tombueng/LumiGate/hardware/3d/XLR-328P.step

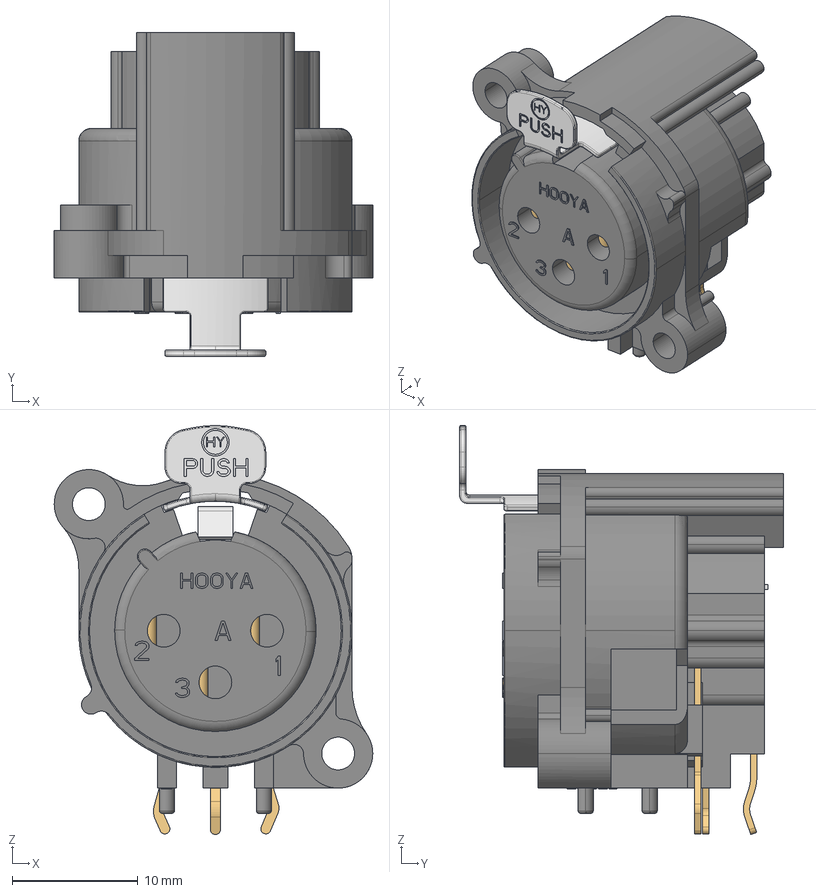
[picture p10: CAD file, 2026-06-14]
hardware/3d/XLR-328P.step
25.3 x 25.7 x 32.5 mm
