tombueng/LumiGate/hardware/lumigate.kicad_pcb

## KiCad design hardware/lumigate.kicad_pcb (2026-06-14)

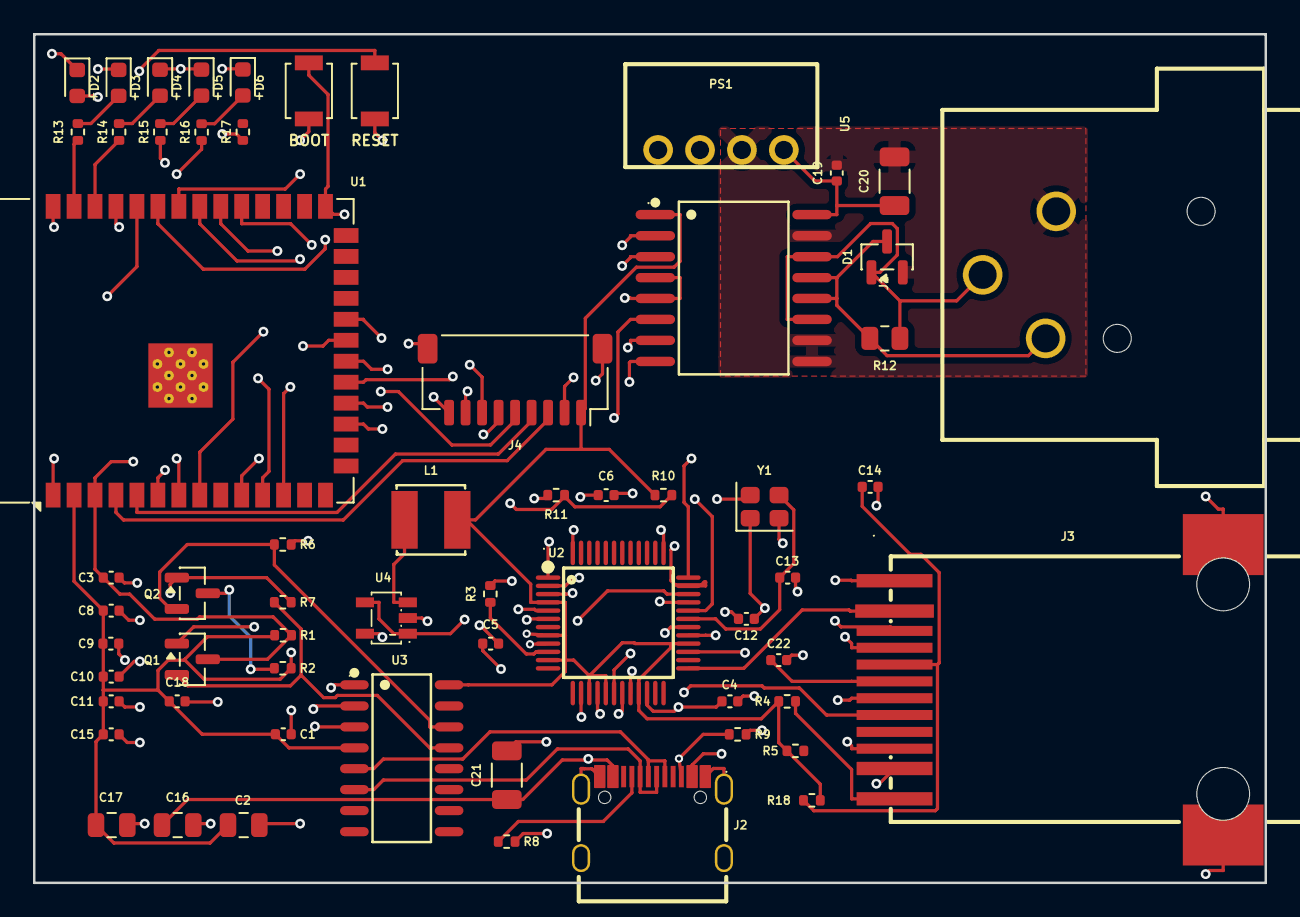
[picture p11: board lumigate.kicad_pcb from above]

Board: 4 copper layers, 74.6 x 51.4 mm, 61 parts (0 on the bottom side), 61 nets.

Parts:
C1, C5, C8, C9, C10, C11, C14, C15, C18, C19, C22: 100nF; C_0402_1005Metric
C2: 10uF; C_0805_2012Metric
C3, C4: 1uF; C_0402_1005Metric
C6: 4.7uF; C_0402_1005Metric
C12, C13: 22pF; C_0402_1005Metric
C16, C17: 22uF; C_0805_2012Metric
C20, C21: 10uF; C_1206_3216Metric
D1: SM712; SOT-23
D2, D3, D4, D5, D6: LED; LED_0603_1608Metric
J1: XLR-3 out; CONN-TH_XLR-328P
J2: USB-C; USB-C_SMD-TYPE-C-31-M-12_1
J3: J3; RJ45-SMD_HR961160C
J4: DISP SH9; JST_SH_SM09B-SRSS-TB_1x09-1MP_P1.00mm_Horizontal
L1: L1; IND-SMD_L4.0-W4.0
PS1: B0505S-1W; PWRM-TH_B0505S-1W
Q1, Q2: MMBT3904; SOT-23
R1, R2, R6, R7, R11: 10k; R_0402_1005Metric
R3: 12k; R_0402_1005Metric
R4, R5: 330R; R_0402_1005Metric
R8, R9: 5k1; R_0402_1005Metric
R10: 45.3k; R_0402_1005Metric
R12: 120R; R_0805_2012Metric
R13, R15: 1k; R_0402_1005Metric
R14, R16, R17: 180R; R_0402_1005Metric
R18: 49.9R; R_0402_1005Metric
SW1: BOOT; SW_SPST_B3U-1000P
SW2: RST; SW_SPST_B3U-1000P
U1: ESP32-S3-WROOM-1-N8; ESP32-S3-WROOM-1
U2: W5500; LQFP-48_L7.0-W7.0-P0.50-LS9.0-BL
U3: U3; SOP-16_L10.0-W3.9-P1.27-LS6.0-BL
U4: SY8089; SOT-23-5_L3.0-W1.7-P0.95-LS2.8-BR
U5: U5; SOIC-16_L10.3-W7.5-P1.27-LS10.3-BL
Y1: 25MHz; Crystal_SMD_2520-4Pin_2.5x2.0mm

Connections:
+3V3: C1.1, C2.1, C8.1, C9.1, C10.1, C11.1, C15.1, C17.1, C18.1, J4.1, L1.2, R1.1, R2.1, R4.1, R5.1, R10.1, R18.2, U1.2, U2.4, U2.8, U2.11, U2.15, U2.17, U2.21, U2.28, U3.4, U3.16, U5.1
+5V: C16.1, C21.1, J2.A4B9, J2.B4A9, PS1.2, U4.1, U4.4
BUCK_FB: R10.2, R11.1, U4.5
BUCK_LX: L1.1, U4.3
CC1: J2.A5, R8.1
CC2: J2.B5, R9.1
DISP_CS: J4.7, U1.34
DISP_DC: J4.8, U1.35
DISP_MOSI: J4.6, U1.33
DISP_RST: J4.9, U1.31
DISP_SCK: J4.5, U1.32
DISP_SCL: J4.4, U1.5
DISP_SDA: J4.3, U1.4
DMX_A: D1.1, J1.3, R12.1, U5.11, U5.14
DMX_B: D1.3, J1.2, R12.2, U5.12, U5.13
DMX_EN: U1.12, U5.4, U5.5
DMX_RX: U1.11, U5.3
DMX_TX: U1.10, U5.6
DTR: Q1.2, R7.1, U3.13
EN: C3.1, Q1.3, R1.2, SW2.1, U1.3
ETH_ACTLED: J3.11, U2.27
ETH_CS: U1.18, U2.32
ETH_INT: U1.22, U2.36
ETH_LINKLED: J3.2, U2.25
ETH_RCT: C22.1, J3.6
ETH_RST: U1.17, U2.37
ETH_RXN: J3.8, U2.5
ETH_RXP: J3.7, U2.6
ETH_TCT: C14.1, J3.5, R18.1
ETH_TXN: J3.4, U2.1
ETH_TXP: J3.3, U2.2
GND: C1.2, C2.2, C3.2, C4.2, C5.2, C6.2, C8.2, C9.2, C10.2, C11.2, C12.2, C13.2, C14.2, C15.2, C16.2, C17.2, C18.2, C21.2, C22.2, D2.1, D3.1, D4.1, D5.1, D6.1, J2.1, J2.2, J2.3, J2.4, J2.A1B12, J2.B1A12, J3.10, J3.13, J3.14, J4.2, J4.MP, PS1.1, R3.2, R8.2, R9.2, R11.2, SW1.2, SW2.2, U1.1, U1.40, U1.41, U2.3, U2.9, U2.14, U2.16, U2.19, U2.29, U2.48, U3.1, U4.2, U5.2, U5.7, U5.8, Y1.2, Y1.4
GNDISO: C19.2, C20.2, D1.2, J1.1, PS1.3, U5.9, U5.10, U5.15
IO0: Q2.3, R2.2, SW1.1, U1.27
LED_B: R16.1, U1.7
LED_G: R14.1, U1.38
LED_R: R13.1, U1.39
LED_W: R17.1, U1.8
LED_Y: R15.1, U1.6
MISO: U1.21, U2.34
MOSI: U1.19, U2.35
unnamed: R3.1, U2.10
unnamed: J3.1, U2.18
unnamed: J3.12, R4.2
unnamed: Q1.1, R6.2
unnamed: D2.2, Q2.1, R7.2
unnamed: D3.2, R13.2
unnamed: D4.2, R14.2
unnamed: D5.2, R15.2
unnamed: D6.2, R16.2
RTS: Q2.2, R6.1, U3.14
S3_RX: U1.36, U3.2
S3_TX: U1.37, U3.3
SCLK: U1.20, U2.33
TOCAP: C6.1, U2.20
USB_DM: J2.A7, J2.B7, U3.6
USB_DP: J2.A6, J2.B6, U3.5
VISO: C19.1, C20.1, PS1.4, U5.16
W5500_1V2: C4.1, C5.1, U2.22
XI: C12.1, U2.30, Y1.1
XO: C13.1, U2.31, Y1.3
