tombueng/LumiGate/(commit log)

2026-05-21 Initial release: LumiGate v1.0
    Art-Net → DMX512 gateway firmware for ESP32 with live WebSocket UI,
    manual DMX control, OTA updates, mDNS, and NVS config persistence.
2026-05-21 Add footer attribution, resize logo for README, wiring diagram SVG
    - Footer with copyright, GitHub link, MIT license on all three web pages
    - docs/logo.png: 300x300 version for README
    - docs/wiring.svg: rendered wiring diagram
2026-05-21 Add logo to web UI nav bar and README
    Serve 96x96 logo PNG from PROGMEM at /logo.png with 24h cache header.
    Replace text/emoji header with <img> on all three pages.
    Add logo to top of README.
    [main.cpp]
2026-05-21 Refactor: separate HTML/assets from firmware source
    - src/pages/*.html — editable templates with {{PLACEHOLDER}} substitution
    - src/assets/logo.png — 96x96 logo, source of truth for web UI
    - extra_scripts.py — pre-build script generates src/generated/*.h
    - src/generated/ is gitignored (auto-created at build time)
    - main.cpp now contains only firmware logic, no inline blobs
2026-05-22 platformio.ini: use --before=no_reset for reliable manual boot mode
    Board has no reliable auto-reset circuit; skip DTR/RTS reset attempt.
2026-05-22 Add auto-incrementing build version and update notification
    - CI sets LUMIGATE_VERSION=1.0.{run_number}; extra_scripts.py writes
    src/generated/version.h with FIRMWARE_VERSION at build time
    - version.txt published as release asset alongside firmware binaries
    - On startup, device fetches version.txt from latest release over HTTPS
    in a background FreeRTOS task (8 s after boot, non-blocking)
    - /version.json endpoint: {current, latest, update}
    - Index page: version shown in navbar subtitle; yellow update banner
    appears if a newer build is available on GitHub
    - Settings page: current version shown next to GitHub update button
    - Local builds default to version "dev"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
2026-05-22 Add ESP32-S3 support, sACN protocol, and runtime LED configuration
    - Dual-target build: esp32dev and esp32s3dev in platformio.ini
    - sACN/E1.31 input on port 5568 with multicast, protocol selectable in UI
    - Runtime LED config (pin + type: plain GPIO or WS2812 RGB) stored in NVS
    with chip-appropriate defaults (GPIO2 plain for ESP32, GPIO48 WS2812 for S3)
    - WS2812 status colours: red=no WiFi, amber=idle, green=DMX active
    - CI builds both firmware variants and releases firmware.bin + firmware-esp32s3.bin
    - Brownout detector disabled to handle marginal USB supplies
    [main.cpp]
2026-05-22 Fix WiFiUDP.h include — redundant on Linux (already in WiFi.h)
    [main.cpp]
2026-05-23 flash.ps1: auto-detect ESP32 vs ESP32-S3, use correct addresses and firmware
    Runs chip_id after boot mode entry, selects correct chip flag,
    baud rate, bootloader address (0x1000 vs 0x0000), and firmware files.
2026-06-04 Use netRSSI() in handleDmxJson for Ethernet-build correctness
    No behavior change on WiFi builds (netRSSI returns WiFi.RSSI there).
    [main.cpp]
2026-06-04 Add static IP config, channel labels, and identify
    - Static IP: optional IP/gateway/subnet/DNS in config (else DHCP),
    applied for both WiFi (setSTAStaticIPConfig) and Ethernet (ETH.config).
    /reset and BOOT-hold portal clear it so recovery always comes up on DHCP.
    - Channel labels: browser-owned JSON blob persisted in NVS via
    GET /labels.json + POST /labels. Shown in grid cells, modal title,
    and change log. Editable from the channel modal.
    - Identify: WS {type:identify,ch} flashes a channel to full on the wire
    for ~1.5 s (driven from loop so it works with no incoming Art-Net),
    without corrupting the stored value the UI/Art-Net see.
    All three targets (esp32dev, esp32s3dev, wt32eth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
    [main.cpp]
2026-06-04 Show changelog in update banner
    CI writes recent commits to changes.txt release asset.
    Device fetches it alongside version.txt (only when update available).
    /version.json gains a notes field; index.html renders it under the banner.
2026-06-04 Gzip-compress bootstrap.min.css at build time (232KB → 30KB)
    Serving 232KB uncompressed was causing WDT resets/crashes on page load.
    extra_scripts.py now gzip-compresses CSS assets before embedding.
    handleBootstrapCss adds Content-Encoding: gzip so browsers decompress.
    [extra_scripts.py, main.cpp]
2026-06-04 Versioned releases, OTA version picker, auto-update, boot/connect/AP LED states
    Releases:
    - CI now publishes preserved per-version releases (v1.0.N) alongside the
    rolling 'latest', each with a per-version changelog (commits since the
    previous tag, filtered to meaningful messages).
    OTA:
    - handleOtaGithub accepts a version arg → installs a specific release
    (firmware URL built per build target incl. wt32eth01).
    - Settings page shows a table of all available versions (version/date/
    changes/install), default latest, current marked "installed".
    - Auto-update switch (persisted via /autoupdate, no reboot) auto-installs
    newer firmware on next boot check.
    - Status banner aggregates all ch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
    [main.cpp]
2026-06-04 Reap dead WebSocket clients via heartbeat
    Browser tabs that close uncleanly left zombie WS connections that
    held slots until the server stopped accepting connections — the web
    UI became unreachable while the device kept running (LED still on).
    enableHeartbeat(15s ping / 3s pong / 2 misses) drops dead clients.
2026-06-04 Fix HTTP socket exhaustion: push senders/log over WebSocket, drop polling
    Browser polled /senders.json + /log.json every 2 s (~1 new TCP conn/s).
    Each closed conn lingers in lwIP TIME_WAIT (~60 s); with only ~16 TCP
    PCBs the device ran out and the HTTP server stopped accepting connections
    (web UI unreachable while loop kept running — LED still lit), recovering
    once TIME_WAITs cleared. Now senders+log are pushed over the existing
    WebSocket every 2 s; the browser no longer polls.
    Also: idle LED is now a clearly-visible amber heartbeat (500/500) instead
    of a 100ms flash every 2 s that looked like the device was off; banner
    version now comes from the live GitHub release list (was stale device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
    [main.cpp]
2026-06-04 LED on its own task (not blocked by web serving); DMX stays in loop
    Reverts the full DMX-in-task experiment (it starved the synchronous
    WebServer of CPU and broke HTTP). DMX output returns to loop()/callbacks
    as before; only the status LED runs in a light independent task so web
    traffic can no longer freeze it. enableDelay(false) removed (it dropped
    connections before the request arrived).
    [main.cpp]
2026-06-04 docs: refresh screenshots, add web-UI walkthrough video
    Regenerate status (now a lit, labelled grid) and settings screenshots.
    Rework docs/screenshot.mjs: robust device resolution (mDNS→IP), OTA
    shots gated behind LUMIGATE_OTA, and a full web-UI walkthrough recorded
    to MP4 + GIF (demonstrates manual control, labels, sparkline, identify,
    blackout, and every setting). Embed the GIF + MP4 link in the README.
2026-06-05 Production stability: WIFI_PS_NONE + continuous 40Hz DMX refresh
    Root cause of the instability (WS offline/Live flapping, 8s HTTP stalls,
    LED blackouts every ~20s with sACN active) was WiFi power-save dropping
    packets — especially multicast (sACN has no link-layer retransmission).
    - WiFi.setSleep(WIFI_PS_NONE): keeps the radio awake so multicast and
    IGMP queries aren't missed. Fixes WS drops and HTTP stalls.
    - Continuous DMX output at 40 Hz in loop() (now free — server is async):
    holds the last frame as a failsafe so brief input gaps never interrupt
    the lights. onDmxFrame only updates the buffer; loop() drives the wire.
    - readSacn() drains all buffered packets per call (catches up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
    [main.cpp]
2026-06-05 Fix web server wedging under load: gzip pages, heap guards, AsyncTCP tuning
    Diagnosis (serial instrumentation): under connection churn the free heap
    collapsed to ~17 KB and AsyncTCP stopped accepting connections — the web
    UI went unreachable while loop/DMX/sACN kept running. Serving the 21 KB
    uncompressed index page per connection was the dominant heap cost.
    - gzip index.html (21 KB→6.7 KB) and config.html (15 KB→4.5 KB) at build
    time; served via beginResponse_P + Content-Encoding: gzip. Pages are now
    fully static (values via /info.json) so gzip is safe.
    - Heap guard: skip WS binary/meta pushes when free heap < 40 KB.
    - Cap WebSocket clients at 4 (cleanupClients(4)).
    - AsyncTCP bu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
    [extra_scripts.py, main.cpp]
2026-06-05 Add WiFi link watchdog + RSSI/status diagnostics
    - Auto-reconnect if the WiFi association drops (status != connected for
    >5s) so the device recovers without a reboot; DMX output is unaffected.
    - HEALTH log now includes rssi and WiFi status for field diagnosis.
    [main.cpp]
2026-06-06 docs: document configurable DMX output pins and UART port selector
    - Features table: add "Configurable DMX pins" row
    - New "DMX Output Pins" section with defaults table per board
    - NVS table: add UART port row, clarify DMX pin row
    - /config route description updated
    - Pinout reference note already in place from previous commit
2026-06-06 fix: harden DMX pin/port config against bad NVS, UART0 misuse, and race
    Five issues found in code review:
    1. UART0 accepted (constrain floor was 0): conflicts with Serial.begin().
    Fix: constrain dmxPort to [1,2] in POST handler; remove UART0 option
    from the HTML dropdown.
    2. NVS values not clamped on load: stale/corrupt dmxPort, dmxTxPin,
    dmxRxPin, dmxRtsPin could reach the driver unchecked.
    Fix: wrap all four prefs.getInt() calls in constrain() in loadConfig().
    3. sendDmx() could fire on new cfg.dmxPort for 600 ms before reboot,
    calling dmx_write on an uninstalled port.
    Fix: set dmxReady=false at the top of handleConfigPost().
    4. HTML defaults (17/16/-1/UART1) would be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
    [main.cpp]
2026-06-06 Add 60-min live show for QLC+ and grandMA3
    QLC+ (qlcplus-show-60min.qxw, generated by make_show_60min.py):
    - 7-act dramatic arc: Awakening → Rising → Peak 1 → Breakdown →
    Build 2 → Climax → Resolution (64 min, loops)
    - 30 distinct effects: sine waves, ripple, heartbeat, thunder, cascade,
    comet (fwd/rev/both), scatter, sparkle, VU bounce, center bloom,
    build/wipe, odd/even, thirds chase, halves, strobe (3 speeds),
    crossfade looks + more
    - 501 XML functions, 147 cued steps, 32 VC buttons (plus LIVE SHOW + BLACKOUT)
    - Per-step timing (fadein/hold/fadeout) for full dramatic control
    grandMA3 (gma3_show.lua — Lua plugin for v2.4.2.2):
    - Load via Menu → Plugins → Load Plu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
2026-06-06 docs: RDM plan — capabilities, Art-Net/sACN architecture, hardware, phased plan
2026-06-06 feat(rdm): RDM controller backend — discovery + GET/SET on the DMX bus
    Phase 1+2 of docs/rdm.md. esp_dmx already exposed a configurable RTS/enable
    pin (cfg.dmxRtsPin); this adds the RDM controller on top:
    - TOD model (RdmDevice[]) with UID, DMX start address, footprint, model,
    personality, sub-device count, software-version label, identify state.
    - rdmService() runs on loop()'s bus thread (sole owner of the DMX port):
    full discovery sweep + per-device GET device-info / SW-version label, plus
    SET dmx-start-address and SET identify. Async WS task only sets request
    flags (rdm_discover / rdm_setaddr / rdm_identify), mirroring the existing
    blackout/identify pattern.
    - GET /rdm.json e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
2026-06-06 feat(rdm): hide Fixtures card until RDM enabled; explain pin mapping
    - Status page: the "Fixtures (RDM)" card is now hidden entirely unless an
    RTS/DE pin is configured (rdm.json available=true). Previously it showed a
    "RDM disabled" placeholder.
    - Settings: rewrote the DMX Output / RDM Pins help — clarifies the values are
    ESP32 GPIO numbers (the GPIOxx label, not header position), maps each to the
    transceiver pin by function with common board aliases (DI/TXD/RXD, RO/RXD,
    EN/DE-RE), notes the A/B + VCC/GND wiring and 120 ohm terminator, and gives
    an S3 + MAX3485 example (TX17→DI, RX16→RO, RTS4→EN).
    Builds clean for esp32s3dev; flashed to the S3 dev unit via OTA.
    Co-Autho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
2026-06-06 Reboot after WiFi config portal so AsyncWebServer can bind port 80
    ERR_CONNECTION_REFUSED after running the WiFiManager captive portal: the
    portal runs its own web server on port 80 and doesn't release the socket
    cleanly, so our AsyncWebServer http.begin() couldn't bind — nothing listened
    on 80 (RST/refused), persisting until a manual reboot.
    Fix: after the portal saves credentials, ESP.restart() for a clean boot
    where auto-connect succeeds and the portal never runs, leaving port 80 free
    for our server. Standard WiFiManager pattern.
    [main.cpp]
2026-06-13 feat(dmx): multiple universes / outputs (issue #4)
    Drive up to 2 independent DMX outputs from one device, each with its own
    universe, UART port and RS485 transceiver. Hardware ceiling is 2: the
    ESP32 / ESP32-S3 expose 3 UARTs and UART0 is the serial console, leaving
    UART1 + UART2.
    - Config: cfg.outputs[2] {enabled, universe, port, tx, rx, rts}; per-output
    NVS keys (o<i>_*) with zero-touch migration from the legacy single-universe
    keys — Output A inherits the old setup, Output B ships disabled, so existing
    single-universe devices are unchanged.
    - Input demux: Art-Net routes each incoming universe to every matching output;
    sACN opens one multicast socket per output universe and filt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
    [main.cpp]
2026-06-13 fix(dmx): make multi-output safe on real hardware + e2e test suite
    Hardware testing of the 2-output feature (issue #4) on an ESP32-S3 surfaced an
    esp_dmx bug and several robustness gaps. This makes two outputs actually work,
    guarantees no config can brick a device, and adds an end-to-end test suite.
    esp_dmx UART2 fix (the blocker)
    - A 2nd DMX port (UART2) panicked on the S3 during driver install (null
    peripheral pointer). Root cause: esp_dmx guards its UART2 entry with
    `#if DMX_NUM_MAX > 2`, but DMX_NUM_MAX is an *enum* the preprocessor reads as
    0, so the UART2 entry was compiled out while the array was still sized for it.
    Fixed with an idempotent build-time patch in extra_scripts.p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
    [extra_scripts.py, main.cpp]
2026-06-13 display: optional OLED / colour OLED status panel (issue #5)
    Add an opt-in on-device status display, plumbed like the status LED and
    off by default. Drives mono I2C OLEDs (SSD1306 128x64/128x32, SH1106
    128x64) and the colour SPI SSD1351 128x128 through one Adafruit_GFX
    renderer.
    - Config: dispType + I2C (SDA/SCL) and SPI (CS/DC/RST/SCK/MOSI) pins +
    rotation, persisted in NVS and exposed via /config (new Display card)
    and /info.json.
    - initDisplay() factory probes the I2C address (0x3C/0x3D), brings up the
    panel and shows a boot splash; rendering runs on its own FreeRTOS task.
    - Height-aware status screen (128x32 / 128x64 / 128x128 hero layout) with
    IP, universe, protocol, FPS, sourc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
    [main.cpp]
2026-06-13 display: production hardening + doc sync
    - Colour SSD1351 renders into a GFXcanvas16 and blits the whole frame via
    drawRGBBitmap(), eliminating the clear-then-redraw flicker of the
    buffer-less direct-draw path (32 KB, allocated only when dispType==4).
    - initDisplay() bails cleanly when no I2C OLED ACKs at 0x3C/0x3D instead of
    driving a phantom panel, and requires a DC pin for the SSD1351.
    - docs/display.md synced to the as-built state (status, buffer model, phases).
2026-06-14 hardware: add LumiGate v3 — open-source 4-layer isolated DMX gateway PCB
    Standalone ESP32-S3 + W5500 board with galvanically-isolated DMX (ISO3086 +
    B0505S), USB-C, JST display header, status LEDs and BOOT/RST buttons. 4-layer,
    fully routed and isolation-validated (0 unconnected/shorts, 0 4mm-isolation
    violations), SPICE-checked analog. Includes the SKiDL source, a placement-driven
    Freerouting-2 routing pipeline, production data (gerbers/BOM/CPL), 3D renders,
    and a full component-rationale + JLCPCB fabrication README. Linked from the main
    README. (Firmware unchanged — master already has the latest.)
    [XLR-328P.step, lumigate.kicad_pcb, lumigate.kicad_sch, lumigate_BOM_jlcpcb.csv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]
